Daniqnn/Proyecto_Final/(list of files, drawings)

Other design files:
PCB/freerouting.dsn
PCB/PCB del Proyecto Final/Final_Proyect/Final_Proyect/freerouting.dsn
