Daniqnn/Proyecto_Final/PCB/Final_Proyect.kicad_pcb

## KiCad design PCB/Final_Proyect.kicad_pcb (2026-03-03)

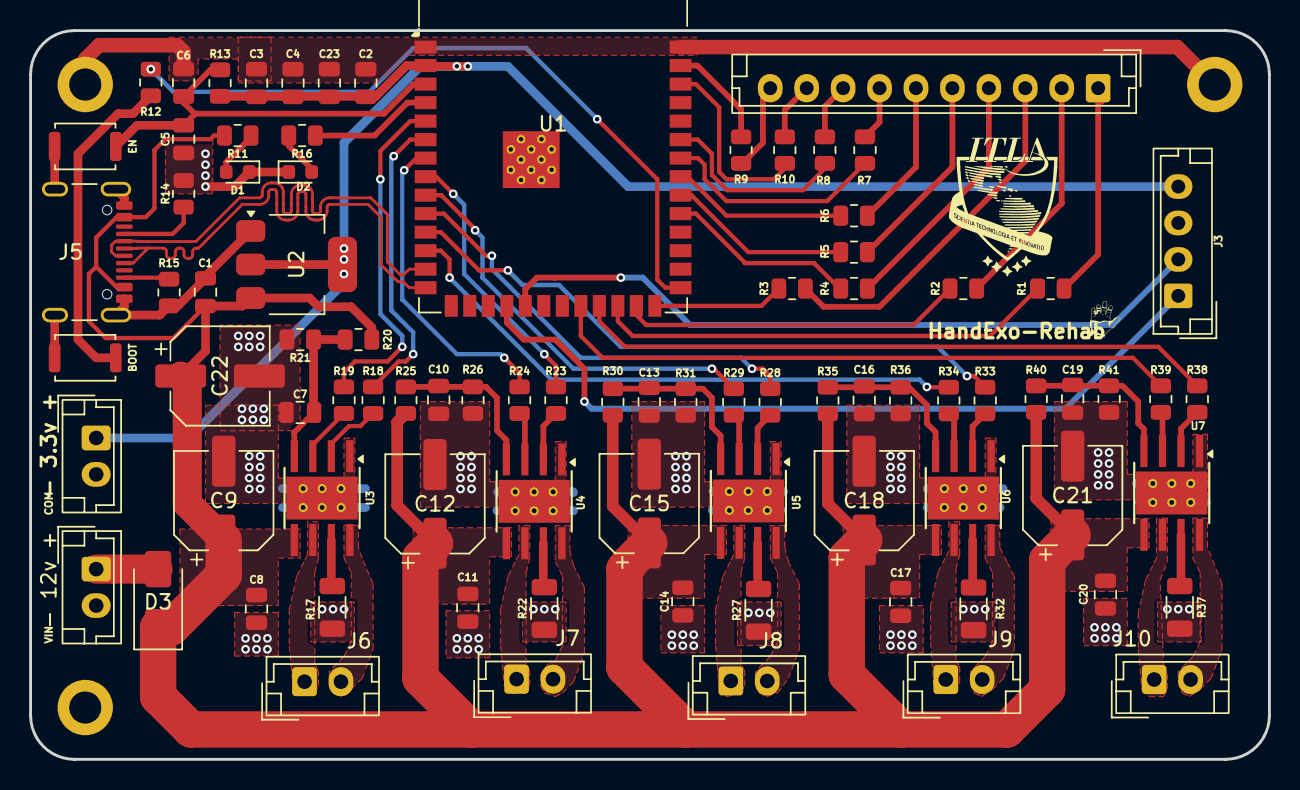
[picture p83: board Final_Proyect.kicad_pcb from above]

Board: 2 copper layers, 85.0 x 50.0 mm, 86 parts (0 on the bottom side), 76 nets.

Parts:
- 3.3v +: VCC GND TTP223; JST_EH_B2B-EH-A_1x02_P2.50mm_Vertical
- 12v +: - +; JST_EH_B2B-EH-A_1x02_P2.50mm_Vertical
BOOT: SW_SPST; SW_Push_SPST_NO_Alps_SKRK
C1: 10uf; C_0805_2012Metric
C2, C4: 22uf; C_0805_2012Metric
C3, C6, C23: 100nf; C_0805_2012Metric
C5: 1uf; C_0805_2012Metric
C7, C8, C10, C11, C13, C14, C16, C17, C19, C20: 100nF; C_0805_2012Metric
C9, C12, C15, C18, C21: 47uF; CP_Elec_6.3x7.7
C22: 220uF; CP_Elec_6.3x7.7
D1, D2: LED; LED_0603_1608Metric
D3: SS18; D_SMA
EN: SW_SPST; SW_Push_SPST_NO_Alps_SKRK
J1: Conn_01x10_Pin; JST_EH_B10B-EH-A_1x10_P2.50mm_Vertical
J3: OLLED I2C; JST_EH_B4B-EH-A_1x04_P2.50mm_Vertical
J5: USB_C; USB_C_Receptacle_GCT_USB4105-xx-A_16P_TopMnt_Horizontal
J6, J7, J8, J9, J10: JST_EH_B2B-EH-A_1x02_P2.50mm_Vertical
R1, R2, R3, R4, R5, R6, R7, R8, R9, R10, R11, R18, R19, R23, R24, R28, R29, R33, R34, R38, R39: 1k; R_0805_2012Metric
R12: 100R; R_0805_2012Metric
R13, R21, R26, R31, R36, R41: 10k; R_0805_2012Metric
R14, R15: 5.1k; R_0805_2012Metric
R16: 330; R_0805_2012Metric
R17, R22, R27, R32, R37: 0.2; R_1206_3216Metric
R20, R25, R30, R35, R40: 80k; R_0805_2012Metric
U1: ESP32-S3-WROOM-1
U2: AMS1117-3.3; SOT-223-3_TabPin2
U3, U4, U5, U6, U7: DRV8870DDA; Texas_HTSOP-8-1EP_3.9x4.9mm_P1.27mm_EP2.95x4.9mm_Mask2.4x3.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

Connections:
+3V3: - 3.3v +.1, C2.1, C3.1, C4.1, C23.1, J3.4, R13.1, U1.2 (3V3), U2.2 (VO)
+12V: C1.1, C8.1, C9.1, C11.1, C12.1, C14.1, C15.1, C17.1, C18.1, C20.1, C21.1, C22.1, D3.1 (K), J5.A4 (VBUS), J5.A9 (VBUS), J5.B4 (VBUS), J5.B9 (VBUS), R11.2, R20.1, R25.1, R30.1, R35.1, R40.1, U2.3 (VI), U3.5 (VM), U4.5 (VM), U5.5 (VM), U6.5 (VM), U7.5 (VM)
/Motor Driver1/IN1: R24.1, U4.3 (IN1)
/Motor Driver1/IN2: R23.2, U4.2 (IN2)
/Motor Driver1/ISEN: R22.1, U4.7 (ISEN)
/Motor Driver1/M1: J7.1, U4.6 (OUT1)
/Motor Driver1/M2: J7.2, U4.8 (OUT2)
/Motor Driver1/VREF: C10.1, R25.2, R26.1, U4.4 (VREF)
/Motor Driver2/IN1: R29.1, U5.3 (IN1)
/Motor Driver2/IN2: R28.2, U5.2 (IN2)
/Motor Driver2/ISEN: R27.1, U5.7 (ISEN)
/Motor Driver2/M1: J8.1, U5.6 (OUT1)
/Motor Driver2/M2: J8.2, U5.8 (OUT2)
/Motor Driver2/VREF: C13.1, R30.2, R31.1, U5.4 (VREF)
/Motor Driver3/IN1: R34.1, U6.3 (IN1)
/Motor Driver3/IN2: R33.2, U6.2 (IN2)
/Motor Driver3/ISEN: R32.1, U6.7 (ISEN)
/Motor Driver3/M1: J9.1, U6.6 (OUT1)
/Motor Driver3/M2: J9.2, U6.8 (OUT2)
/Motor Driver3/VREF: C16.1, R35.2, R36.1, U6.4 (VREF)
/Motor Driver4/IN1: R39.1, U7.3 (IN1)
/Motor Driver4/IN2: R38.2, U7.2 (IN2)
/Motor Driver4/ISEN: R37.1, U7.7 (ISEN)
/Motor Driver4/M1: J10.1, U7.6 (OUT1)
/Motor Driver4/M2: J10.2, U7.8 (OUT2)
/Motor Driver4/VREF: C19.1, R40.2, R41.1, U7.4 (VREF)
/Motor Driver/IN1: R19.1, U3.3 (IN1)
/Motor Driver/IN2: R18.2, U3.2 (IN2)
/Motor Driver/ISEN: R17.1, U3.7 (ISEN)
/Motor Driver/M1: J6.1, U3.6 (OUT1)
/Motor Driver/M2: J6.2, U3.8 (OUT2)
/Motor Driver/VREF: C7.1, R20.2, R21.1, U3.4 (VREF)
A+: R18.1, U1.6 (IO6)
A-: R19.2, U1.5 (IO5)
B+: R23.1, U1.8 (IO15)
B-: R24.2, U1.7 (IO7)
BOOT: R12.2, U1.27 (IO0)
C+: R28.1, U1.10 (IO17)
C-: R29.2, U1.9 (IO16)
D+: J5.A6 (D+), J5.B6 (D+), U1.14 (USB_D+)
D-: J5.A7 (D-), J5.B7 (D-), U1.13 (USB_D-)
E+: R33.1, U1.11 (IO18)
E-: R34.2, U1.12 (IO8)
EN: C5.1, C6.2, EN.1 (A), R13.2, U1.3 (EN)
F+: R38.1, U1.23 (IO21)
F-: R39.2, U1.22 (IO14)
GND: - 3.3v +.2, - 12v +.2, BOOT.2 (B), C1.2, C2.2, C3.2, C4.2, C5.2, C6.1, C7.2, C8.2, C9.2, C10.2, C11.2, C12.2, C13.2, C14.2, C15.2, C16.2, C17.2, C18.2, C19.2, C20.2, C21.2, C22.2, C23.2, D1.1 (K), D2.1 (K), EN.2 (B), J3.3, J5.A1 (GND), J5.A12 (GND), J5.B1 (GND), J5.B12 (GND), J5.S1 (SHIELD), R14.2, R15.2, R17.2, R21.2, R22.2, R26.2, R27.2, R31.2, R32.2, R36.2, R37.2, R41.2, U1.1 (GND), U1.40 (GND), U1.41 (GND), U2.1 (GND), U3.1 (GND), U3.9 (GND), U4.1 (GND), U4.9 (GND), U5.1 (GND), U5.9 (GND), U6.1 (GND), U6.9 (GND), U7.1 (GND), U7.9 (GND)
Led: R16.2, U1.4 (IO4)
unnamed: BOOT.1 (A), R12.1
unnamed: D1.2 (A), R11.1
unnamed: D2.2 (A), R16.1
unnamed: - 12v +.1, D3.2 (A)
unnamed: J1.1, R1.1
unnamed: J1.2, R2.1
unnamed: J1.3, R3.1
unnamed: J1.4, R4.1
unnamed: J1.5, R5.1
unnamed: J1.6, R6.1
unnamed: J1.7, R7.1
unnamed: J1.8, R8.1
unnamed: J1.9, R10.1
unnamed: J1.10, R9.1
unnamed: J5.A5 (CC1), R14.1
unnamed: J5.B5 (CC2), R15.1
SCL: J3.2, U1.19 (IO11)
SDA: J3.1, U1.18 (IO10)
SIG1: R10.2, U1.38 (IO2)
SIG2: R9.2, U1.39 (IO1)
SIG3: R8.2, U1.35 (IO42)
SIG4: R7.2, U1.34 (IO41)
SIG5: R6.2, U1.33 (IO40)
SIG6: R5.2, U1.32 (IO39)
SIG7: R4.2, U1.31 (IO38)
SIG8: R3.2, U1.26 (IO45)
SIG9: R2.2, U1.25 (IO48)
SIG10: R1.2, U1.24 (IO47)
