Daniqnn/Proyecto_Final/(commit log)

2026-02-07 Actualizacion 7/2/26
    [DRB8870.kicad_sch, Final_Proyect.kicad_pcb, Final_Proyect.kicad_sch, freerouting.dsn]
2026-02-08 Actualizacion diseño PCB
    [Final_Proyect.kicad_pcb, Final_Proyect.kicad_sch]
2026-02-08 Actualizacion de Drivers
    [Final_Proyect.kicad_pcb]
2026-02-09 Version enrutada
    [DRB8870.kicad_sch, Final_Proyect.kicad_pcb, Final_Proyect.kicad_sch, freerouting.dsn]
2026-02-09 version enrutada 1.0
    [DRB8870.kicad_sch, Final_Proyect.kicad_pcb, Final_Proyect.kicad_sch, freerouting.dsn]
2026-02-20 Enrutamiento mejorado
    [DRB8870.kicad_sch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]
2026-04-14 Actualizacion de codigo
2026-04-19 Actualizacion Codigo (Control de velocidad)
